anandijain/fusion-models/README.md

# houses some fusion models 

todo - 
* finish and order pcbs  
* refactor a bunch of code to import a module that defines the steppers, the escs, stores a dict of pico * pinouts
* estop 
* fix the interference between the solenoid holder and the flywheels, chamfer 
* redesign the solenoid holder to have the hopper and the time of flight sensor
* figure out how to programatically export every combination in a onshape part to a 3d file (export zip of all configurations)
* see if theres a way to select a bunch of things a queue one big download 
* just get both motors working againx
* test tilt 
* notebooklm 

----------
breadboard/perfboard layout pico pinout

yaw driver:
dir - 16
step - 17
!sleep 10
!reset 11
ms3 12
ms2 13
ms1 14
~en 15

pitch driver:
dir 18
step 19
!sleep 20 
!reset 21
ms3 22 
ms2 26
ms1 27
~en 28

solenoid/mosfet gate - 9
esc2 - 8
esc1 - 7

9/21 plan
* GET POINT AND SHOOT WORKING 
* control solenoid with pico 
* drill holes into bottom plate for mounting 
* mount assembly to wood flatform 
* print maybe end stream 
* write the code that does a test where it shoots, rotates 90 degrees left and shoots again goes back right and shoots  
* 2 axis design? 
* use configurations to make both gears so i only need one model 
* cable notch hole in bottom plate
* mounting holes in bottom plate
done:

done: 
* model solenoid with fusion sheet metal (30 mins)
* update model of yaw only to work with solenoid ()

9/13/24 
todo:
  * hopper design
  * 2 axis bldc cad 
  * record video of brushed stall in pitch 

done:
  * design the feeder for just one shot (for now) using time of flight and a servo 
  * obs teleport 
  * make a better prompt for kcl and really stress test it 
  * write some thorough notes on zoo.dev what i like and dont 

feeder fixes:
  raiser and pusher - more clearance for fasteners
  the pusher gets stuck and just jams a ball into the wall
  the channel lets balls through with no compression (how tf did i mess this up)
  fix placement of the mounting holes also make there be 4 of them 

todo
  - control pico from android wired to see if its faster 
  - mount pico and driver to bottom plate 
  - [ ] the pitch holder should be screwed together with the coupler instead of just awkwardly joined to it
  - use a belt to couple the stepper and pitch holder to save footprint
  - commit to this repo the ISOMetricprofile.xml file with a huge matrix of differently pitched threads 
  - BOM 
  - at some point probably find a power supply to 3A to power both steppers
  - protoboard so wires dont keep falling out
  - custom pcb to see how small i can get things 
  - make delay a query parameer
  - redo assembly animation with rest of fasteners
  * bldc - get new motors (good to have and learn how to use) 
  * 3d printable latching assemblies 
  * rust embassy Pico w 
  * switch to pose detection, basically max out frame rate and latency. also slim tf down out of the app to just what I need. also maybe look into model quantization - fun ml thing I've never done
  * "guitar hero but every time you mess up you get shot" 
  * bearing redesign
  * design an adjustable width flywheel projectile shooter for different amounts of compression and sized objects
  * model/experimentally determine the compression of the nerf rival round
  * reprint bottom plate with 5mm wall thickness but make the necesary changes 
  * longer dc motor wires 
  * add phone mount to front of pitch holder
  * edit search_timeline script to select the TimelineObjects to easily find them 
  * come up with a funny acronym for the project
  * design a mechanism to clamp in the dc motor power connectors for easy (dis)assembly
  * test tracking latency 
  * add the o connectors to the DC motor model 
  * design a terminal block or latching connector for them 
  * speed curves and microstepping 
  * making a new android app thats just pose detection and api calls/ serial 

completed
  - create a level shifter with a transistor to give 5v logic to driver from pico 
      - resolved by using a motor driver (a4988) that cnan handle 3.3v logic
  - probably need to redesign shaft collar to use real metal screws as set screws
  - add a way for the coupler to slot into the bottom plate and be aligned with the mounting screws
    - made irrelevant by gears
  - add bolt to prevent horizontal movement of the top plate in cad 
  - fix pitch bearing holder holes to be 1) m5 2) the mirror of the holes for the stepper holder to make it easier to assemble (dont have to put on the holder before screwing in the big yaw gear)
  - single cable power-use a 5v regulator to power the pico from the 19v supply
    * get a motor working (with pwd speed control)
  * get a kilawatt for the ps 
    - at full speed current draw is only 1/3 A 
  * get 4 pin male male headers for plugging in motors 
  * solder headers onto the pico 
  * design the flywheel and mounting stuff for the dc motors   
  * get the face tracker working again 
  * fix design of bldc flywheel to fit into top plate and print
  * get as5600 working again while mounted to the flywheel
    - test if i can sample faster with arduino/cpp (upython gives me about 2600 samples a second with no printing)
  * mount flywheel to something heavy
  * fix 3d printer

for code/esp/serial_test.py 
1) run it and if you want ot just use the python repl as the serial then done
2) close that terminal tab, disable micropico ext. restart exts.
3) open serial monitor and send whatever 

for stepper_with_joints:
the m5x2x10s mount the phone holder
the 16s are the set screws

https://grabcad.com/library/mg995-servo-3
https://grabcad.com/library/mg-996r-servo-motor-1

note for the m8 model you will likely have to paste in the following to the following path. this video explains how to add custom thread types to fusion https://www.youtube.com/watch?v=VPDngPAvFnQ

for laptop 
C:\Users\anand\AppData\Local\Autodesk\webdeploy\production\4826aec956713f599d57385857ff62484fd50dd3\Fusion\Server\Fusion\Configuration\ThreadData\ISOMetricprofile.xml

for desktop 
C:\Users\anand\AppData\Local\Autodesk\webdeploy\production\35f4ba95ffc4701e35102fa6485053ed4c1923cf\Fusion\Server\Fusion\Configuration\ThreadData\ISOMetricprofile.xml

```xml
<ThreadSize>
    <Size>8.0</Size>
    <Designation>
      <ThreadDesignation>M8x2</ThreadDesignation>
      <CTD>M8x2</CTD>
      <Pitch>2</Pitch>
      <Thread>
        <Gender>external</Gender>
        <Class>6g</Class>
        <MajorDia>7.866</MajorDia>
        <PitchDia>7.101</PitchDia>
        <MinorDia>6.4455</MinorDia>
      </Thread>
      <Thread>
        <Gender>internal</Gender>
        <Class>6H</Class>
        <MajorDia>8.17</MajorDia>
        <PitchDia>7.268</PitchDia>
        <MinorDia>6.7795</MinorDia>
        <TapDrill>6.75</TapDrill>
      </Thread>
      <Thread>
        <Gender>external</Gender>
        <Class>4g6g</Class>
        <MajorDia>7.866</MajorDia>
        <PitchDia>7.1225</PitchDia>
        <MinorDia>6.467</MinorDia>
      </Thread>
    </Designation>
  </ThreadSize>
  ```
