anandijain/fusion-models/part_docs.md

stepper driver pinout http://hiletgo.com/ProductDetail/1952643.html
stepper (has CAD) https://www.omc-stepperonline.com/nema-17-bipolar-59ncm-84oz-in-2a-42x48mm-4-wires-w-1m-cable-connector-17hs19-2004s1
pico w pinout https://datasheets.raspberrypi.com/picow/PicoW-A4-Pinout.pdf
bldc https://www.flashhobby.com/d3536-fixed-wing-motor.html, https://grabcad.com/library/d3536-brushless-motor-1
esc https://img.staticbg.com/file/products/20181029014609251400-1100V1.0FlyDragonLite2-4S.pdf
magnetic encoder 
mosfet - https://www.infineon.com/dgdl/Infineon-IRFZ44N-DataSheet-v01_01-EN.pdf?fileId=5546d462533600a40153563b3a9f220d
