anandijain/fusion-models/BOM.md

name, link, qty, price
stepper, https://www.amazon.com/dp/B00PNEQKC0, 2, 13.99
A4988 stepper driver, https://www.amazon.com/dp/B07BND65C8, 1, 10.19
https://www.amazon.com/Generic-Raspberry-Pi-Pico-W/dp/B0B72GV3K3, 1, 18.65
https://www.amazon.com/Pcs-Header-MazerPi-Raspberry-Pico/dp/B09F2NZ3GB, 1, 5.99
https://www.amazon.com/dp/B09PKD8QZZ, 6.99
https://www.amazon.com/DROK-Controller-Regulator-Industrial-Optocoupler/dp/B06XGD5SCB/, 1, 14.40
https://www.amazon.com/Torque-Bearings-Wheels-Upgrade-Bracket%EF%BC%89/dp/B0BW73PV2S?th=1, 1, 28.99
https://www.amazon.com/Universal-Regulated-Switching-Transformers-Surveillance/dp/B07J6SBJ5L/, 1, 14.39
magnetic encoder, https://www.amazon.com/Teyleten-Robot-Precision-Induction-Measurement/dp/B09LMB3PTZ
