anandijain/fusion-models/(list of files, cad)

Other CAD files:
misc/lazy_susan2 v9.f3z
misc/lead screw assembly v3.f3z
misc/pan holder 2 v4.f3d
misc/planetary_gears v3.f3d
misc/stepper_with_joints v8.f3z
