anandijain/fusion-models/assembly.md

assembling the pan 

parts:
* 2 bottom plate mounting brackets
* 2 flywheels
* 1 motor mount 
* 1 solenoid holder
* 4 pillars
* 1 small gear 
* 1 big gear
* 1 top plate
* 1 bottom plate
* 2 d3536 bldcs (flashhobby) with the mounting bracket and collet 
* 1 nema 17 stepper motor

assembly
1) use self tapping to put the 4 pillars in 
* put the nema motor into the hole in the bottom plate facing up and use bolts to fasten it 
* put the small gear on the shaft and use set screws and nuts to fasten
2) put mounting brackets on bottom plate 
3) put the bldcs together with flywheels and the mounting bracket on 
4) use nuts and bolts to tightly clamp the motors down to the motor mount
* nuts and bolts to tighten down the solenoid feeder assembly to the top plate 
5) now screw in the big gear to the top plate (m4x8x6 threaded inserts) 
but the motor mount is not high enough to get the center bolt in (the bolt that keeps the top and bottom plates axially aligned)
so you need to put the bolt in from the bottom, then the nuts on top
- heres where things are bad with the assembly. 
without threaded inserts. its easiest to now fasten the motor mount to the top plate. 
when doing this make sure you put the cables of the bldc on the same side 

onshape fixes:
fix the bottom plate mounting bracket. the holes dont line up 
done:
bldc magnet needs at least a small hole in the motor mount 
botht he bldc<-> motor mount hole spacing and the nema hole spacing seems too tight and too close together 

painting frame wood:

all pine 
all 2x2" 
3 9ft 
2 8ft
6 4ft 

all 2x4s
2 8ft 

8 ft^2 1/2" plywood
