anandijain/fusion-models/(commit log)

2024-08-09 add custom 2 pitch nuts and bolts. add note on how to add custom threads
    [m16 v2.f3d, m4x2 v2.f3d, m8 v2.f3d]
2024-08-15 add planetary gear assembly and add my nuts and bolts library
    [planetary_gears v3.f3d]
2024-08-17 add flathead slot to m5x2x16
2024-08-17 add stepper_with_joints
    [stepper_with_joints v8.f3z]
2024-08-27 add lead screw
    [lead screw assembly v3.f3z, planetary_gears v3.f3d]
2024-08-29 add some docs and increase step delay time for better torque. it stalls at 300 us
    [pico_back_and_forth.py, pico_back_and_forth_xy.py, pico_w_blink.py]
2024-08-29 add a program that does concurrent movement of the motors
2024-08-29 add v2
    [lazy_susan2 v9.f3z, pan holder 2 v4.f3d, stepper_with_joints v8.f3z]
2024-08-29 working control of yaw and pitch over webserver
2024-08-30 add assembly todo
2024-09-07 add dc motor control with pico, also get esp32 controlling the steppers
2024-09-07 ramping code to prevent stalling
    [pico_dual_ramp.py, simul_ramp.py]
2024-09-08 add step_and_shoot.py
    add some stuff to the bom
    make a code folder
2024-09-12 add some code to serially control both steppers
    also add a code to test the bldc
2024-09-19 add magnetic encoder code and data
2024-09-23 add assembly instructions for yaw-only
2024-10-15 wood frame
